vmixhd/vmixiocase/README.md

# vMix IO System Guide

## Introduction

vMix IO is software that runs on Windows or Linux. It is designed to convert live video and audio signals between a compatible capture card and the Open Media Transport (OMT) protocol.

The following provides instructions to build a compact computer to handle a total of **8x 1080p60 signals**. 

In order to achieve the small form factor, a Mini-ITX motherboard, Flex ATX PSU and PCIe riser cable have been used. A 3D-printed custom case has been designed for housing these specific components. If building in a larger case, consider using more cost-effective components.

## What you will need

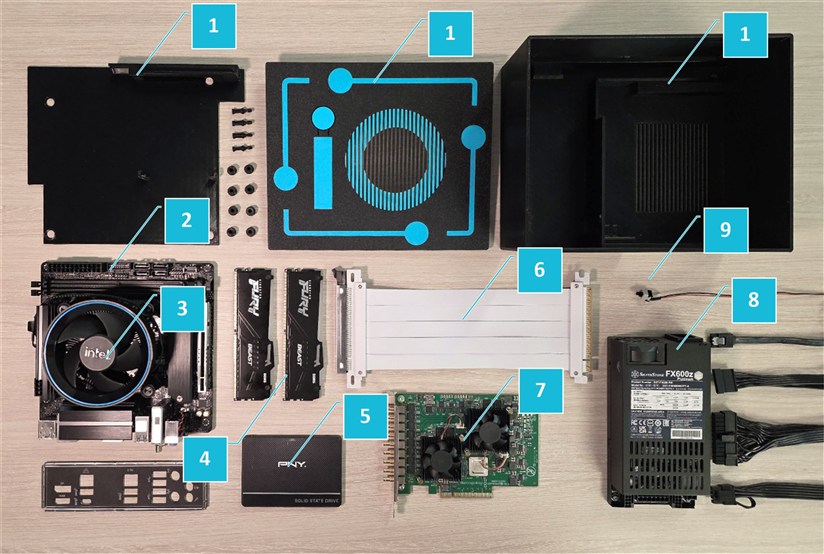
[picture p1: images/00-parts-overview.jpg]
Parts overview


| # | Part | Details | Link |
|---|---|---|---|
| 1 | Case | 3D printed case components | [STL files](stl/) |
| 2 | Motherboard | ASRock B860i WiFi | [Amazon](https://www.amazon.com/ASRock-LGA1851-B860I-WiFi-Motherboard/dp/B0DRTW765T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) |
| 3 | CPU | Intel Core Ultra 5 225 with included stock cooler | [B&H Photo](https://www.bhphotovideo.com/c/product/1860687-REG/intel_bx80768225_core_ultra_5_225.html) |
| 4 | RAM | Kingston Fury Beast DDR5 2x8GB | [Amazon](https://www.amazon.com/Kingston-Technology-5600MT-Computer-KF556C40BBK2-16/dp/B09T8VWV2R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) |
| 5 | SSD | PNY 250GB 2.5" drive, including SATA cable | [B&H Photo](https://www.bhphotovideo.com/c/product/1523158-REG/pny_technologies_ssd7cs900_250_rb_250gb_cs900_ssd.html) |
| 6 | PCIe riser cable | Straight (180 Degree) 200mm PCIe 4.0 | [Amazon](https://www.amazon.com/EZDIY-FAB-Bandwidth-Extension-Compatible-Straight-20cm/dp/B0FCLC8L9B/136-7500014-9714316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) |
| 7 | Capture card | BMD DeckLink Quad 2 - 8x 1080p60 SDI | [B&H Photo](https://www.bhphotovideo.com/c/product/1186263-REG/blackmagic_design_bdlkdvqd2_decklink_quad_2_8_channel.html) |
| 8 | PSU | Silverstone FX600Z 600W modular Flex ATX power supply, including power cables | [Amazon](https://www.amazon.com/Silverstone-Technology-Platinum-Cybenetics-SST-FX600-PM/dp/B0FWJ2Z571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) |
| 9 | Power switch | 2-Pin momentary PC case power switch | [Amazon](https://www.amazon.com/Warmstor-3-Pack-Desktop-Button-Computer/dp/B072FMVZJZ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) |

## Assembly

### 1. Print the case components

Printer used: Bambu Lab A1 with AMS (for multi-colour).

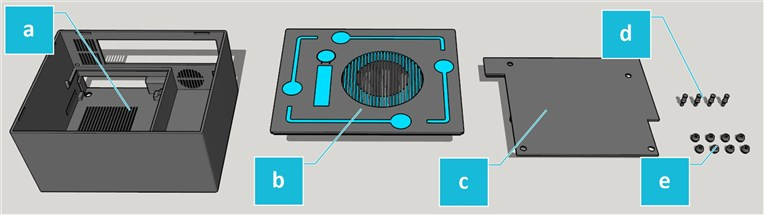
[picture p2: images/01-print-parts.jpg]
Printed parts


| Label | Qty | Part | Material | Print settings | STL (Rev1.0) |
|:-----:|:---:|---|---|---|---|
| a | 1 | Case | PETG, single colour | Print upright, Supports on | [vMix-IO-Case-Rev1.0.stl](stl/vMix-IO-Case-Rev1.0.stl) |
| b | 1 | Lid | PETG, dual colour | Print face down, supports off | [vMix-IO-Lid-Rev1.0.stl](stl/vMix-IO-Lid-Rev1.0.stl) |
| c | 1 | Motherboard plate | PETG, single colour | Print face down, supports off | [vMix-IO-Plate-Rev1.0.stl](stl/vMix-IO-Plate-Rev1.0.stl) |
| d | 4 | Pins | PETG, single colour | Print pointing up, supports off | [vMix-IO-Pin-Rev1.0.stl](stl/vMix-IO-Pin-Rev1.0.stl) |
| e | 8 | Standoffs | TPU, single colour | Print pointing down, supports off | [vMix-IO-Standoff-Rev1.0.stl](stl/vMix-IO-Standoff-Rev1.0.stl) |

The Pin and Standoff STLs are single parts, so print the quantities listed above.

### 2. Fit the motherboard plate standoffs

Press 4x TPU standoffs into the 4x holes on the flat side of the motherboard plate.

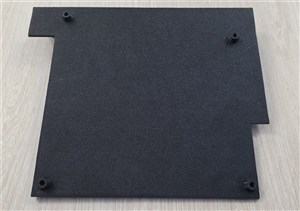
[picture p3: images/02-plate-standoffs.jpg]
Motherboard plate standoffs


### 3. Fit the case feet

Press 4x TPU standoffs into the 4x holes on the underside of the case to form feet.

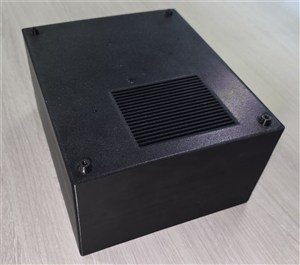
[picture p4: images/03-case-feet.jpg]
Case feet


### 4. Attach the PCIe riser to the capture card

With the DeckLink Quad 2 upside-down, connect the PCIe riser cable and bend the cable upwards.

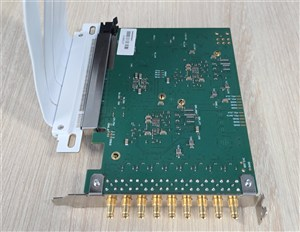
[picture p5: images/04-riser-on-card.jpg]
Riser connected to capture card


### 5. Install the capture card

Install the DeckLink Quad 2 by sliding the PCIe mounting bracket into the slots in the case. Ensure the card is pushed to the back of the case so that it sits flat and the bracket is nearly flush with the outside of the case (**a**).

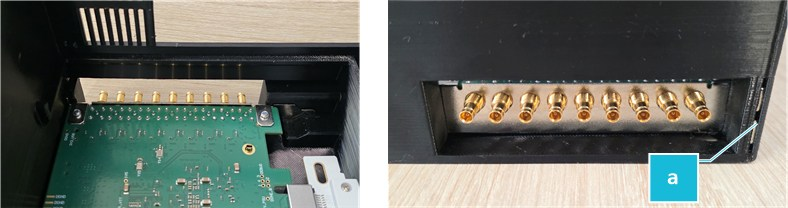
[picture p6: images/05-install-capture-card.jpg]
Installing the capture card


### 6. Connect the power supply cables

Connect the following cables to the power supply:

- Motherboard
- CPU
- SSD power
- *If using a powered capture card, also install a PCIe cable*

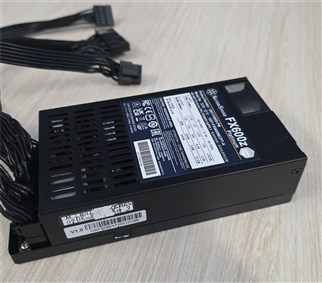
[picture p7: images/06-psu-cables.jpg]
Power supply cables


### 7. Install the power supply

Install the power supply, ensuring the power cable surround fits flush with the case cut-out (**a**).

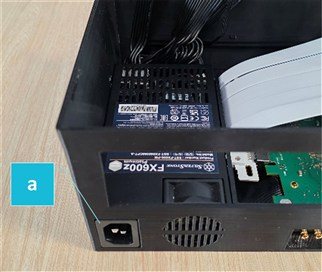
[picture p8: images/07-install-psu.jpg]
Installing the power supply


### 8. Prepare the cables

- **(a)** Run the motherboard power cable up.
- **(b)** Flex the PCIe riser over the capture card, then flex up at the wall.
- **(c)** Run the remaining power supply cables along the channel (keeping below the height of the power supply and ridge) and then up at the wall together with the PCIe riser.

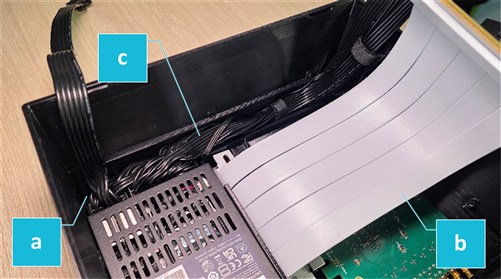
[picture p9: images/08-cable-routing.jpg]
Cable routing


### 9. Connect the SSD cables

Connect the SATA and power cable to the SSD.

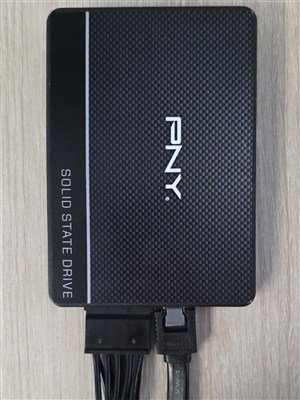
[picture p10: images/09-ssd-cables.jpg]
SSD cables


### 10. Clip the SSD into the motherboard plate

Position the motherboard plate with the flat side facing away and the protrusion at the top, then clip the SSD into the space provided.

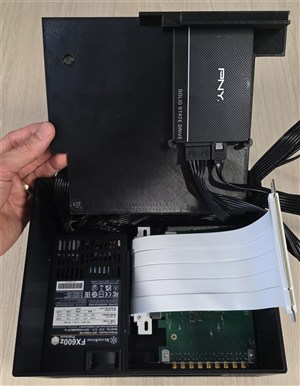
[picture p11: images/10-ssd-clip.jpg]
Clipping the SSD in


### 11. Install the motherboard plate

Lift the motherboard plate up and then rotate it down beyond 90 degrees, positioning the plate-top on the inner wall ledge above the capture card ports (**a**). Then hinge the plate down and clip it into the remaining wall ledges (**b**).

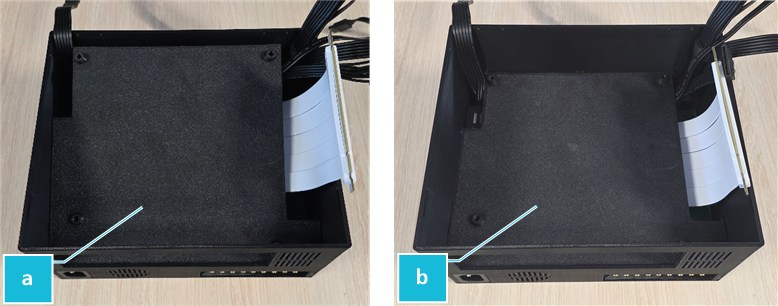
[picture p12: images/11-plate-install.jpg]
Installing the motherboard plate


### 12. Check the plate is seated correctly

If the above is completed correctly:

- The motherboard plate should be sitting level and hard against the power supply.
- The cables should be running up the voids around the plate.
- The plate underside protrusion should be sitting over the capture card to hold it in place.

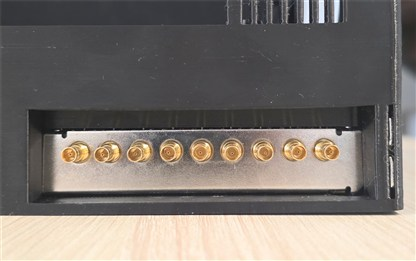
[picture p13: images/12-plate-seated.jpg]
Plate correctly seated


### 13. Install the motherboard back plate

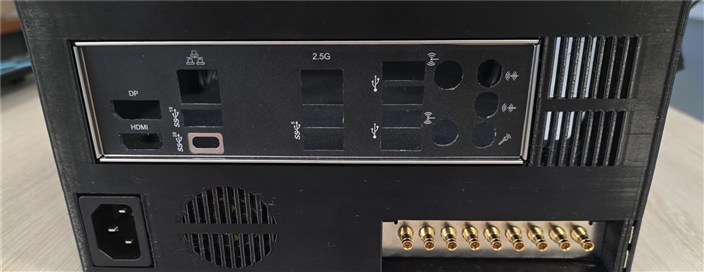
[picture p14: images/13-backplate.jpg]
Motherboard back plate


### 14. Install the RAM, CPU and CPU cooler

Install these onto the motherboard.

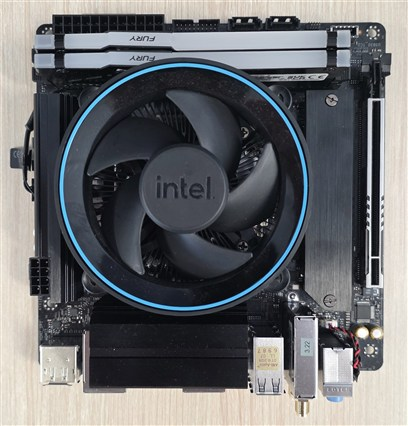
[picture p15: images/14-cpu-ram-cooler.jpg]
RAM, CPU and cooler


### 15. Mount the motherboard

Place the motherboard onto the standoffs on the motherboard plate and align it with the back plate and the screw holes. Then push a pin into each of the four holes, ensuring each one clicks into place.

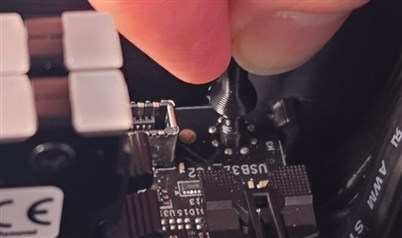
[picture p16: images/15-pins.jpg]
Pinning the motherboard


### 16. Install the power switch

Install the power switch into the case lid.

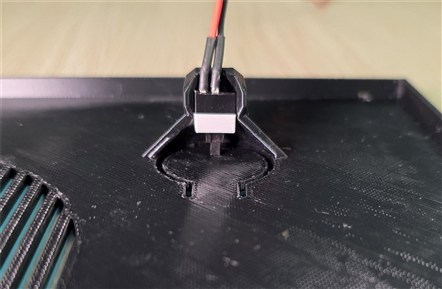
[picture p17: images/16-power-switch.jpg]
Power switch in lid


### 17. Connect the motherboard, SATA and power switch cables

Connect the motherboard (**a**), SATA (**b**) and power switch (**c**) cables to the motherboard.

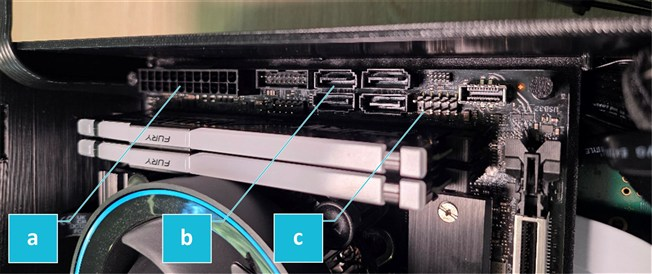
[picture p18: images/17-motherboard-cables.jpg]
Motherboard, SATA and power switch cables


### 18. Connect the CPU power and PCIe riser cables

Connect the CPU power (**a**) and the PCIe riser (**b**) cables to the motherboard.

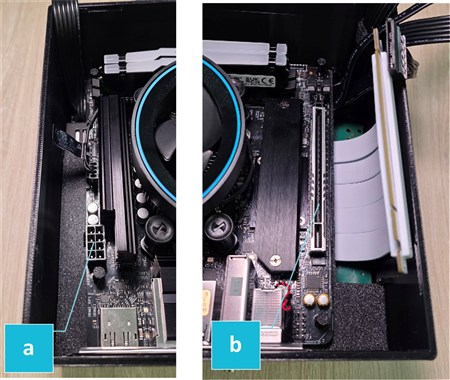
[picture p19: images/18-cpu-power-riser.jpg]
CPU power and PCIe riser cables


### 19. Tidy the cables

Ensure cables are tidy and secure.

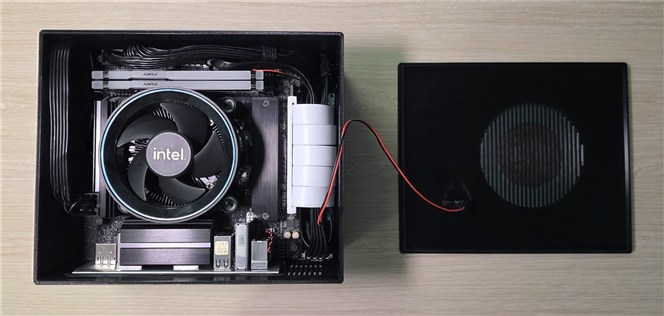
[picture p20: images/19-tidy-cables.jpg]
Tidy cables


### 20. Fit the lid

Fit the lid, ensuring that the CPU fan aligns with the ventilation slots.

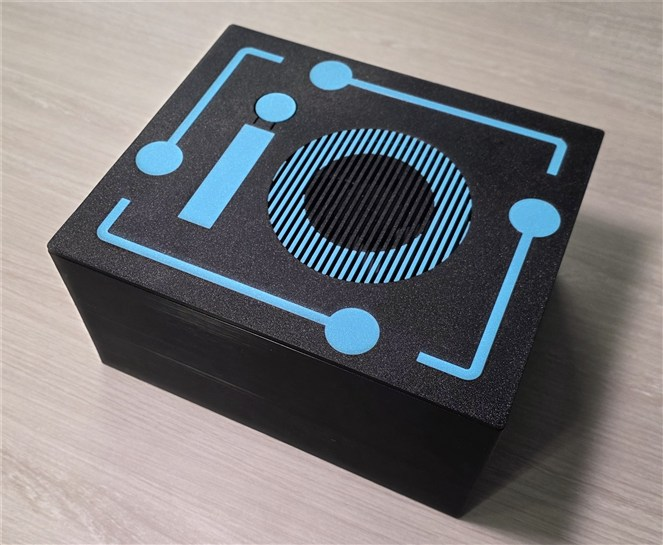
[picture p21: images/20-fit-lid.jpg]
Lid fitted
