vmixhd/vmixiocase/stl/vMix-IO-Case-Rev1.0.stl

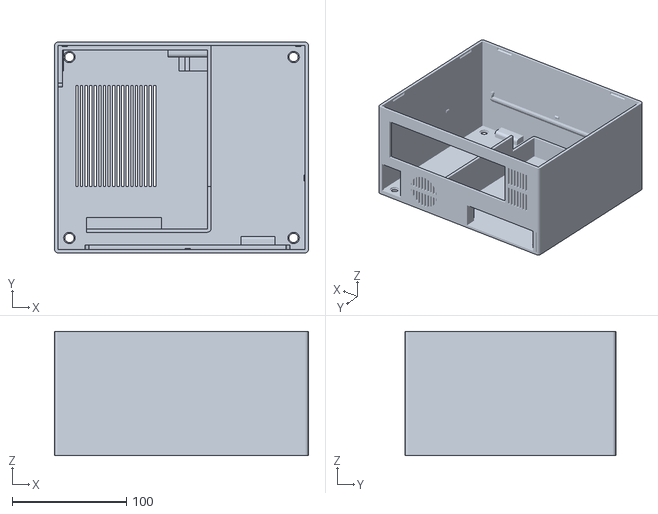
[picture p22: CAD file, 2026-10-08]
stl/vMix-IO-Case-Rev1.0.stl
222.0 x 184.2 x 108.8
