vmixhd/vmixiocase/stl/vMix-IO-Lid-Rev1.0.stl

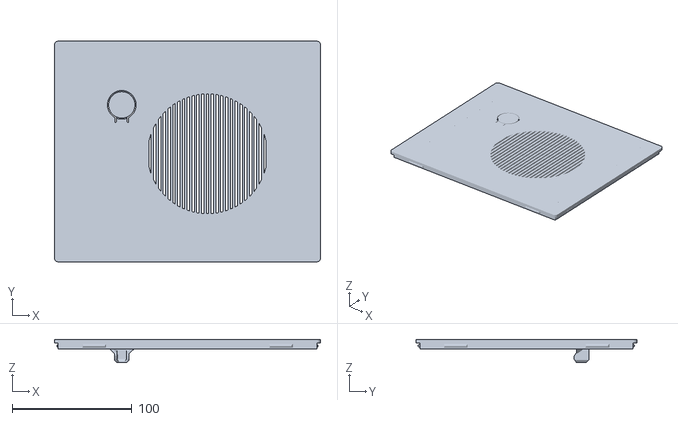
[picture p23: CAD file, 2026-10-08]
stl/vMix-IO-Lid-Rev1.0.stl
222.0 x 184.2 x 19.6
