vmixhd/vmixiocase/stl/vMix-IO-Plate-Rev1.0.stl

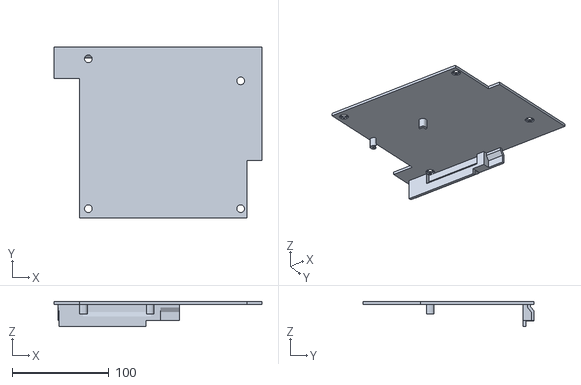
[picture p24: CAD file, 2026-10-08]
stl/vMix-IO-Plate-Rev1.0.stl
215.0 x 177.2 x 26.0
