vmixhd/vmixiocase/stl/vMix-IO-Standoff-Rev1.0.stl

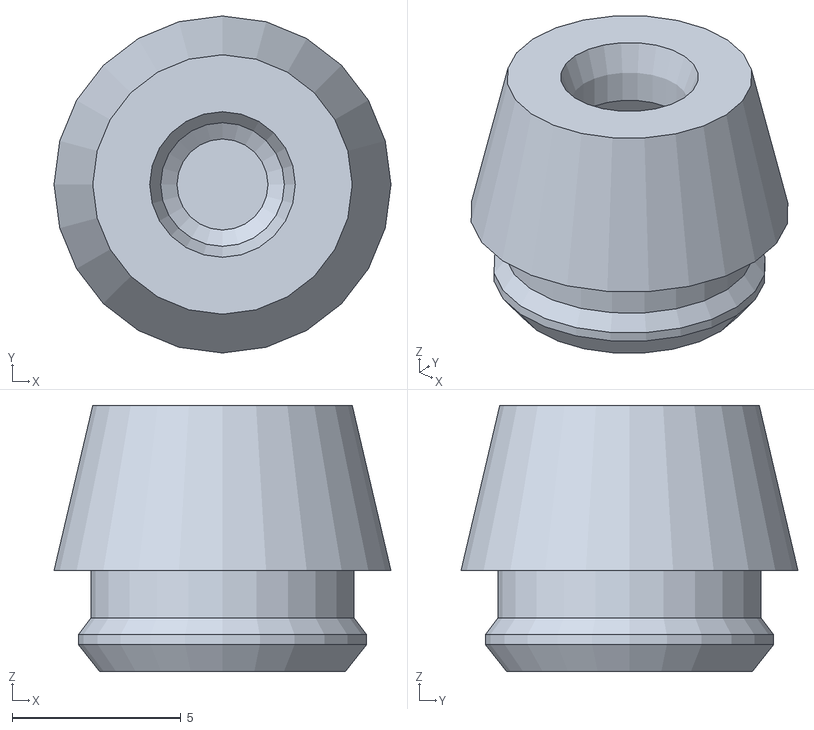
[picture p25: CAD file, 2026-10-08]
stl/vMix-IO-Standoff-Rev1.0.stl
10.0 x 10.0 x 7.90
