vmixhd/vmixiocase/stl/vMix-IO-Pin-Rev1.0.stl

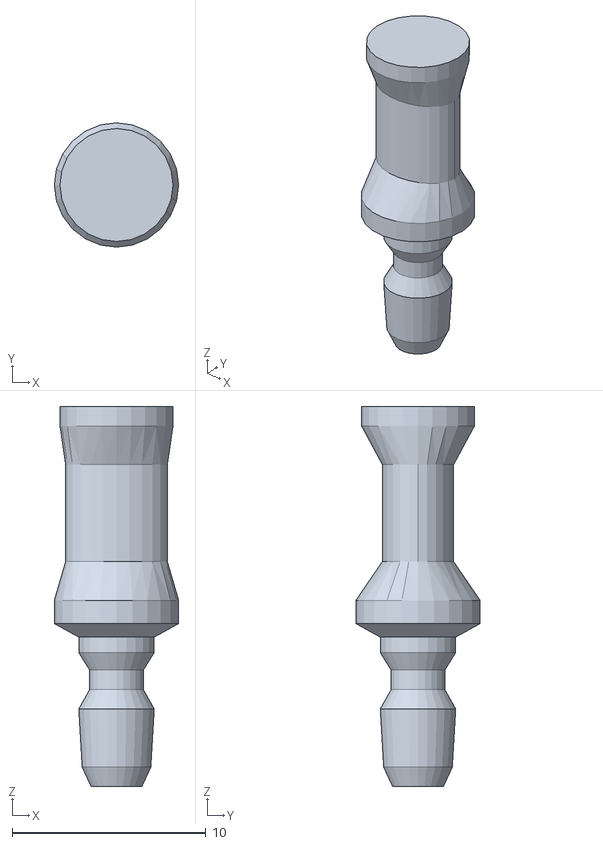
[picture p26: CAD file, 2026-10-08]
stl/vMix-IO-Pin-Rev1.0.stl
6.42 x 6.42 x 19.6
